lingjiawang511/ali_main_control/ali_main_control/调试备注.txt

外部信号的输入都用switch语言判断，0-1-0，1-0-1，这两个过程代表一个接收状态的完整。比如电机启动的时候先检测一下传感器的信号，
记录当下的状态，如果是1，那么下一个状态必然为0，当再下一个状态为1是代表回到原点，要停止电机。出药检测同理。
按键输入和装药管检测使用定时器扫描检测。

		通讯协议
1、使用扫描头通讯协议，以每个柜组发药单为帧，没帧里面包含N个通道的发药数量，PC上位机一次性发送给主控板，主控板解析后发给发药柜组，发药柜组反馈
状态先保存在主控板，等主控板接收完所有的反馈状态，以帧为单位主动上传给PC上位机，PC发药之后需要等待接收到状态之后才可以进行下一次发药，但是两个
柜组相互独立，PC没接收到1柜组的发药状态是可以对2柜组发药的。
2、通讯方式使用应答方式，上位机发数据给下位机，下位机收到后马上应答收到的数据是否正确。然后执行发药，发药完成后下位机把发药状态发给上位机
3、通讯总共16个字节，帧头尾四个字节，数据10个字节，校验2个字节。
4、通讯采用交换主从机模式，发药前，上位机是主机，下位机是从机！发药后下位机是主机，上位机是从机。
5、PC机发送控制信号，MCU接收到正确的信号，响应一次并转化为主机模式，执行相应动作，如果PC此时因为干扰没有收到正确的响应而继续发控制数据，MCU不作处理，需要上位机自己做判断。
	连续发三次无响应当正确接收处理。MCU执行完相应的动作后。主动发送结果信息给PC机，PC正确响应马上转化为从机模式以接受下一次控制信息，PC机错过响应超过三次当正确响应处理，
	如果PC机一直没有响应，超时后当正确处理，同样转化为从机模式。

////***************************下位机和上位机通讯协议 上位机发送***********************************////

05 06 01 04 01 01 02 A3 07    //柜组1,4行1列发药2盒
05 06 01 04 10 01 02 F3 02    //柜组1,4行16列发药2盒

05 06 02 04 01 01 02 E7 07   //柜组2,4行1列发药2盒
05 06 02 04 10 01 02 B7 02   //柜组2,4行16列发药2盒
05 06 02 04 08 01 02 37 05   //柜组2,4行8列发药2盒

05 06 01 05 01 01 02 A2 FB   //柜组1,5行1列发药2盒
05 06 01 05 10 01 02 F2 FE   //柜组1,5行16列发药2盒

05 06 02 05 01 01 02 E6 FB   //柜组2,5行1列发药2盒
05 06 02 05 10 01 02 B6 FE   //柜组2,5行16列发药2盒
05 06 02 05 08 01 02 36 F9   //柜组2,5行8列发药2盒

05 06 00 00 11 10 00 13 A3	//传送皮带向左持续运动
05 06 00 00 11 20 00 07 A3	//传送皮带向右持续运动
05 06 00 00 11 00 00 1E	63  //传送皮带向右持续运动
05 06 00 00 11 10 0A 93 A4  //传送皮带向左运动10S
05 06 00 00 11 20 08 06 65  //传送皮带向右运动8S

05 03 00 00 0F 00 01 BF F0 //读取外围机构状态
05 03 00 00 1F 00 01 BE 35   //读取温度
05 03 00 00 2F 00 01 BE 3A  //读取湿度
05 03 00 00 63 00 01 7F ED   //读取版本号

04 06 04 01 01 02 59 3E	 //直接控制水平板发药，不经主控板转发
04 06 04 02 01 02 A9 3E
04 03 04 00 63 00 6C 5F  //直接读取水平板版本号，不经主控板转发

04 06 04 02 0B 02 AF 9E
04 06 04 01 11 02 54 FE
04 06 04 01 0B 02 5F 9E

05 06 01 01 01 01 01 E3 CA
05 06 01 02 01 01 01 E3 8E
05 06 01 03 01 01 01 E2 72
05 06 01 04 01 01 01 E3 06
05 06 01 05 01 01 01 E2 FA
05 06 01 06 01 01 01 E2 BE
05 06 01 07 01 01 01 E3 42
05 06 01 08 01 01 01 E0 56
05 06 01 09 01 01 01 E1 AA
05 06 01 0A 01 01 01 E1 EE
05 06 01 0B 01 01 01 E0 12
05 06 01 0C 01 01 01 E1 66
05 06 01 0D 01 01 01 E0 9A
05 06 01 0E 01 01 01 E0 DE
05 06 01 0F 01 01 01 E1 22

05 06 01 01 01 01 01 E3 CA
05 06 01 01 02 01 01 13 CA
05 06 01 01 03 01 01 42 0A
05 06 01 01 04 01 01 F3 CB
05 06 01 01 05 01 01 A2 0B
05 06 01 01 06 01 01 52 0B
05 06 01 01 07 01 01 03 CB
05 06 01 01 08 01 01 33 C8
05 06 01 01 09 01 01 62 08
05 06 01 01 0A 01 01 92 08
05 06 01 01 0B 01 01 C3 C8
05 06 01 01 0C 01 01 72 09
05 06 01 01 0D 01 01 23 C9
05 06 01 01 0E 01 01 D3 C9
05 06 01 01 0F 01 01 82 09
05 06 01 01 10 01 01 B3 CF
