lingjiawang511/ali_main_control/阿里售药柜控制板与PC机通讯协议V15.00.02.DOCX

阿里售药柜控制板与PC机通讯协议V15.00.02 2018-12-20

1、初始版本号：V15.00.00 创建日期：2018-11-28

2、历史版本号：V15.00.01 修改日期：2018-12-11 修改格式

3、最新版本号：V15.00.02 修改日期：2018-12-20 增加双通道发药指令

一、PC机与主控板通讯方式要求：

1、2个柜组，每个柜组18层，16通道均分，主控板与PC机采用RS232与网口两种通讯方式,与水平板采用RS485总线通讯方式。16进制格式，(115200，N,8,1)

2、PC机主动向主控板发送发药命令，主控板将水平板的最终发药情况（发药完成、空轨道、卡药）主动上传给PC机；

3、当振动传感器发出振动信号时，主控板将振动信号主动发送给PC机；

4、PC机查询温湿度信号，主控板将读取温湿度数据并上传给PC机；

5、PC机主动向主控板发送其它外围机构命令，主控板接收并执行命令；PC机查询各机构状态，主控板返回各机构当前状态；

6、接收方收到发送方数据时，需要回复数据。

7、ModBus通讯协议分为ASCII模式和RTU模式，主控板采用RTU模式的通讯协议,CRC16(0x8005)校验，低位在前高位在后。115200bps 8bit 1stop none

8、由于水平板支持同时发药所以上位机必须注意以下事项：

1）、每层最多允许3个模块同时工作；

2）、每个柜组最多允许6个模块同时工作；

3）、整台设备最多允许7个模块同时工作。

违反以上规定会引起由电压不足造成出药异常。

二、CRC校验：

Modbus－RTU 使用 CRC（循环冗余检查 Cyclic Redundancy Check）进行纠错。 CRC 码使用 CRC1－16（X16＋X15＋X2＋1）的生成多项式计算得出。

1．CRC 生产顺序

1） CRC 的初始值设置为 FFFFh。

2） 计算命令的首个字节数据（从站地址）和 CRC 的 XOR， 将其结果设定为 CRC。

3） CRC 右移 1bit。

4） 根据 3）的右移移出位为 0 时，重复 3）；

如果移出位为 1 时，将 A001h 和 CRC 进行异或，其結果设置为 CRC，返回至 3）。

5） 3）和 4）反复进行 8 次右移。

6） 命令的下一个字节也同样从 2）到 5）进行反复处理。

7） 将命令的所有字节的完成上述操作后得到纠错的 CRC。

8） 在命令的最后附加 CRC 时， 请将 CRC 的低位字节设定在前，将高位字节设定在后（低字节序）。

2．命令中 CRC 的配置

命令中发送的 16-bitCRC 为低字节序，先发送低位字节、后发送高位字节。 以下用 CRC 的值为 4321h 为例，先发送21h,后发送43h。

3．CRC 错误判定 PC机设置的 CRC 的值与主控板接收的命令数据計算的 CRC 的值比较后，不一致时，判定 CRC 错 误，废弃接受的数据。然后，准备下一次的接收。（不出现报警状态。）

三、主控板与PC机通讯指令格式： Modbus数据结构（16进制格式）

1、发送写命令：PC机—>主控板 AD + 06 + ID(3字节) + Function(2字节) + CRC16(2字节)

从机地址AD:[0] | 命令字Com：[1] | 机构代码ID:[2] | 机构代码ID:[3] | 机构代码ID:[4] | 机构功能Fun[5] | 机构功能Fun[6] | CRC16[7] | CRC16[8]
05:从机地址 | 06:写命令 | Group 组： 01：1柜组 02：2柜组 | Line 行： 发药通道所在行，取值范围：0~30(10进制) | Column 列： 发药通道所在列，取值范围：0~20(10进制) | 01：单通道发药命令 11：双通道发药命令；（新增） | 指定通道的发药数量：1~20(10进制) | CRC_L | CRC_H
| | 0x000011：传送皮带 | | | 0：停止
| | | | | 10：向左运动 20：向右运动 | 0：持续运动 XX：(1~255)秒，运行到设定时间参数后停止
| | 0x000022:闸门 | | | 00：左闸门 0x0，0左关 0x0，1左开 01：右闸门 0x1，0右关 0x1，1右开 | 闸门自动关时间
| | 0x000033:发药超时错误 | | | 0x0000:固定

返回：主控板—>PC机

从机正确接收并可执行主机指令回复：同PC机发送数据相同

从机发生错误时不能执行主机指令回复：

05 + 86 + ID(3字节) + Reason (2字节) + CRC16(2字节)

Reason：不能执行主机指令原因

0004：从机设备故障，从机执行主机请求的动作时出现不可恢复的错误。

0006：从机设备忙碌，从机正忙于处理一个长时程序命令，请求主机在从机空闲时发送信息。

2、发送读命令：PC机—>主控板 PC机查询各机构状况：只查询外设状态(传送皮带、闸门、温湿度、版本号)

从机地址AD:[0] | 命令字KE：[1] | 机构代码ID:[2][3][4] | 机构功能Fun[5] | 机构功能Fun[6] | CRC16[7] | CRC16[8]
05:从机地址 | 03:读命令 | 0x00000F:外围机构状态代码 | 0x0001：固定格式 | | CRC_L | CRC_H
| | 0x00001F：温湿度状态代码
| | 0x000063:读取版本号代码

从机回复：主控板—> PC机 主控板返回各机构状况 05 + 03 + ID(3字节) + Station(2字节) + CRC16(2字节)

从机地址AD:[0] | 命令字KE：[1] | 机构代码ID:[2][3][4] | 机构功能Fun[5] | 机构功能Fun[6] | CRC16[7] | CRC16[8]
05:从机地址 | 03:读命令 | 0x00000F: 外围机构状态代码 | 低4位： 0：左闸门关闭 1：左闸门打开 2：左闸门打开或者关闭异常报警 3：左闸门发生堵药报警，此时闸门处于打开状态 高4位： 0：传送皮带停止 2：传送皮带左转 3：传送皮带右转 | 低4位： 0：电动滚筒无报警 1：电动滚筒有报警 高4位： 0：右闸门关闭 1：右闸门打开 2：右闸门打开或者关闭异常报警 3：右闸门发生堵药报警，此时闸门处于打开状态 | CRC_L | CRC_H
| | 0x00001F：温度状态代码 | 温度 (最高位是正负符号位) | 温度
| | 0x00002F: 湿度状态代码 | 湿度（湿度只有正数） | 湿度
| | 0x000063:读取版本号代码 | Version(2字节)

3、主控板主动向PC机上传数据： 将发药最终状态、振动传感器有信号、有取药动作时主动上传

AD + Command + ID(3字节) + State + Result + CRC16(2字节)

从机地址AD:[0] | 命令字Com：[1] | 机构代码ID:[2] | 机构代码ID:[3] | 机构代码ID:[4] | 状态 State[5] | 结果 Result[6] | CRC16[7] | CRC16[8]
06:PC机地址 | 06:写命令 | Group 组： 01：1柜组 02：2柜组 | Line 行： 发药通道所在行，取值范围：0~30(10进制) | Column 列： 发药通道所在列，取值范围：0~20(10进制) | 指定通道的已经完成的发药数量。 | 发药机反馈状态： 02时为命令正常完成； 03时为命令完成后通道堵塞； 04时为命令完成，但药品未完全发出 | CRC_L | CRC_H
| | 0x000041：振动传感器 | | | 0x0001：有振动发生
| | 0x000051:取药动作 | | | 0x0001：有取药动作
| | 0x000061:有药通过闸门 | | | 0x0000：左闸门有药通过 0x0001：右闸门有药通过
| | 0x000071:闸门堵药 | | | 0x0000：左闸门堵药 0x0001：右闸门堵药

PC机回复与主控板发送数据相同

4、发药流程：

1）、PC机向主控板发送传送皮带连续运动指令，主控板回复并执行动作

2）、PC机向主控板发送发药指令

3）、PC机向主控板发送闸门打开指令(根据传送皮带运动方向)

4）、主控板向上位机主动发送发药情况及发药数量，闸门开2s(时间可设置)，闸门关闭 （此过程都由主控板自行完成）

5）、PC机查询各机构状态，若闸门关闭就向主控板发送传送皮带停止指令

6）、主控板向PC机主动发送有取药动作情况，出药完成。

注：如果没有上述一系列发药流程，PC机收到取药动作，可屏蔽此信息，即：取药动作无效

韦乐海茨（上海）医药设备科技有限公司 内部文件 保密
