lingjiawang511/ali_main_control/hardware/V15_电路图（20181207）/阿里售药柜主控板外框图.pdf

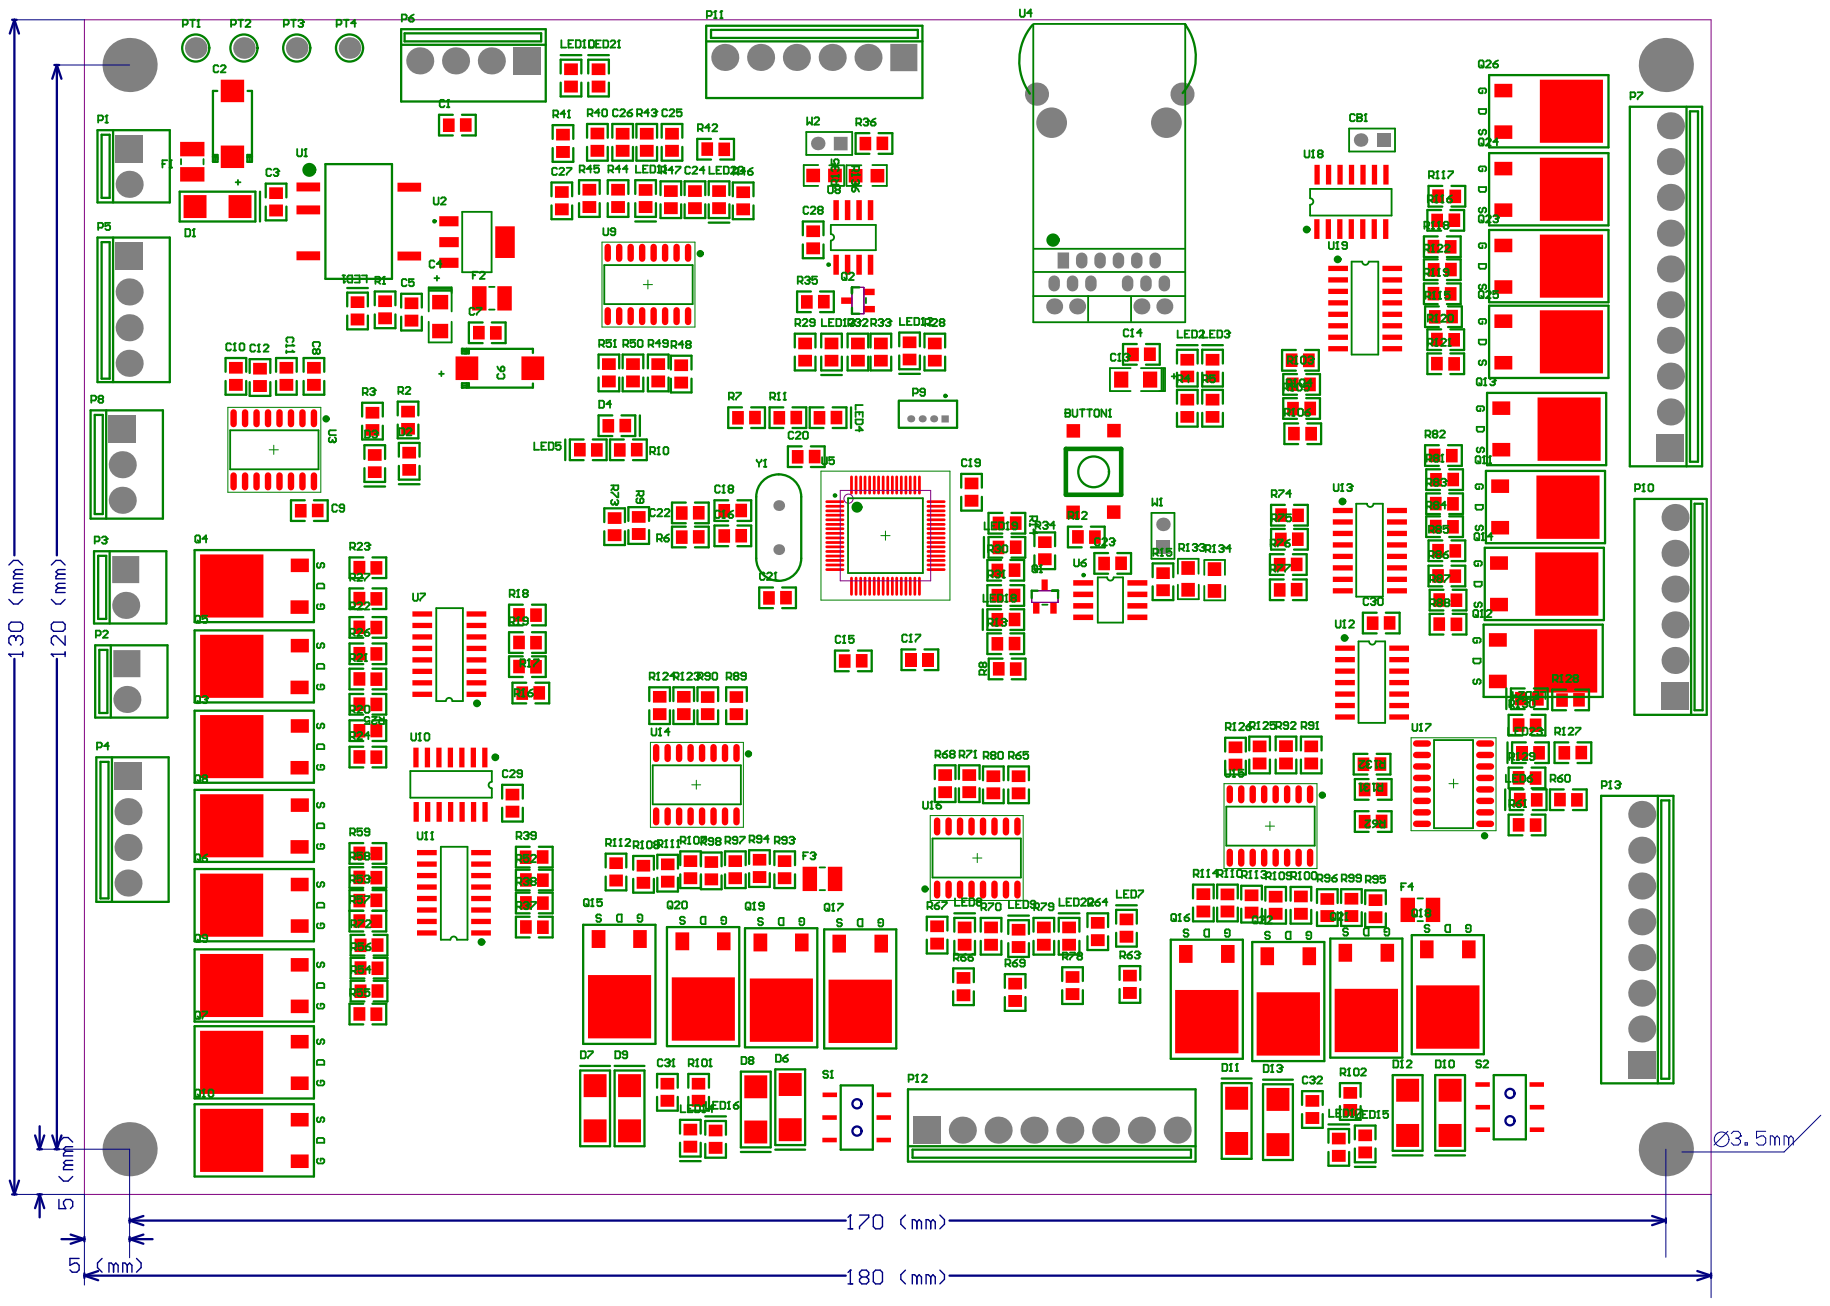
[picture p4: page 1]
