lingjiawang511/ali_main_control/(list of files, drawings)

Other design files:
hardware/Ali_Main_Board/Ali_Main_Board.PrjPCB
hardware/Ali_Main_Board/Ali_Main_Board.SchDoc
hardware/V15_电路图（20181207）/Main Board_V15.PrjPCB
hardware/V15_电路图（20181207）/Main Board_V15.SchDoc
