lingjiawang511/ali_main_control/ali_main_control/include/LGgate.h

#ifndef __LGGATE_H
#define __LGGATE_H

#include "stm32f10x.h"

//baffle_inter 先定义为错误位置，baffle_outer定义为确认位置,BAFFLE_OFF失电是错误位置

#define				A_LEFT_GATE_IO					 GPIO_Pin_3
#define				A_LEFT_GATE_PORT			   GPIOC
#define				A_LEFT_GATE_RCC					 RCC_APB2Periph_GPIOC
#define				B_LEFT_GATE_IO					 GPIO_Pin_0
#define				B_LEFT_GATE_PORT				 GPIOB
#define				B_LEFT_GATE_RCC			  	 RCC_APB2Periph_GPIOB

#define				A_RIGHT_GATE_IO					 GPIO_Pin_1
#define				A_RIGHT_GATE_PORT			   GPIOB
#define				A_RIGHT_GATE_RCC				 RCC_APB2Periph_GPIOB
#define				B_RIGHT_GATE_IO					 GPIO_Pin_12
#define				B_RIGHT_GATE_PORT				 GPIOB
#define				B_RIGHT_GATE_RCC			   RCC_APB2Periph_GPIOB


#define       A_LEFT_GATE_SET   			GPIO_SetBits(A_LEFT_GATE_PORT, A_LEFT_GATE_IO)
#define       A_LEFT_GATE_RESET 	 	 	GPIO_ResetBits(A_LEFT_GATE_PORT,A_LEFT_GATE_IO)
#define       B_LEFT_GATE_SET   			GPIO_SetBits(B_LEFT_GATE_PORT, B_LEFT_GATE_IO)
#define       B_LEFT_GATE_RESET 	 	 	GPIO_ResetBits(B_LEFT_GATE_PORT,B_LEFT_GATE_IO)

#define       A_RIGHT_GATE_SET   			GPIO_SetBits(A_RIGHT_GATE_PORT, A_RIGHT_GATE_IO)
#define       A_RIGHT_GATE_RESET 	 	 	GPIO_ResetBits(A_RIGHT_GATE_PORT,A_RIGHT_GATE_IO)
#define       B_RIGHT_GATE_SET   			GPIO_SetBits(B_RIGHT_GATE_PORT, B_RIGHT_GATE_IO)
#define       B_RIGHT_GATE_RESET 	 	 	GPIO_ResetBits(B_RIGHT_GATE_PORT,B_RIGHT_GATE_IO)

#define      LEFT_GATE_OPEN  				do{A_LEFT_GATE_SET;B_LEFT_GATE_RESET;}while(0);	
#define      LEFT_GATE_CLOSE  			do{B_LEFT_GATE_SET;A_LEFT_GATE_RESET;}while(0);
#define      LEFT_GATE_RELEASE  		do{A_LEFT_GATE_SET;B_LEFT_GATE_SET;}while(0);	

#define      RIGHT_GATE_OPEN  			do{A_RIGHT_GATE_SET;B_RIGHT_GATE_RESET;}while(0);	
#define      RIGHT_GATE_CLOSE  			do{B_RIGHT_GATE_SET;A_RIGHT_GATE_RESET;}while(0);	
#define      RIGHT_GATE_RELEASE  		do{A_RIGHT_GATE_SET;B_RIGHT_GATE_SET;}while(0);


#define				LEFT_OPEN_IO					   	GPIO_Pin_6
#define				LEFT_OPEN_PORT			   		GPIOA
#define				LEFT_OPEN_RCC					 		RCC_APB2Periph_GPIOA
#define				LEFT_CLOSE_IO					 		GPIO_Pin_7
#define				LEFT_CLOSE_PORT				 		GPIOA
#define				LEFT_CLOSE_RCC			  	 	RCC_APB2Periph_GPIOA

#define				RIGHT_OPEN_IO					 		GPIO_Pin_5
#define				RIGHT_OPEN_PORT			  		GPIOC
#define				RIGHT_OPEN_RCC				 		RCC_APB2Periph_GPIOC
#define				RIGHT_CLOSE_IO				 		GPIO_Pin_6
#define				RIGHT_CLOSE_PORT					GPIOC
#define				RIGHT_CLOSE_RCC			   		RCC_APB2Periph_GPIOC


#define READ_LOPEN_SENSOR    		GPIO_ReadInputDataBit(LEFT_OPEN_PORT,LEFT_OPEN_IO)
#define READ_LCLOSE_SENSOR    	GPIO_ReadInputDataBit(LEFT_CLOSE_PORT,LEFT_CLOSE_IO)

#define READ_ROPEN_SENSOR    		GPIO_ReadInputDataBit(RIGHT_OPEN_PORT,RIGHT_OPEN_IO)
#define READ_RCLOSE_SENSOR    	GPIO_ReadInputDataBit(RIGHT_CLOSE_PORT,RIGHT_CLOSE_IO)

#define				LEFT_SHIPMENT_IO					   	GPIO_Pin_4
#define				LEFT_SHIPMENT_PORT			   		GPIOC
#define				LEFT_SHIPMENT_RCC					 		RCC_APB2Periph_GPIOC
#define				RIGHT_SHIPMENT_IO					 		GPIO_Pin_7
#define				RIGHT_SHIPMENT_PORT				 		GPIOC
#define				RIGHT_SHIPMENT_RCC			  	 	RCC_APB2Periph_GPIOC

#define				GETOUT_MEDICINE_IO					 	GPIO_Pin_3
#define				GETOUT_MEDICINE_PORT				 	GPIOB
#define				GETOUT_MEDICINE_RCC			  	 	RCC_APB2Periph_GPIOB

#define READ_LEFT_SHIPMENT_SENSOR    		GPIO_ReadInputDataBit(LEFT_SHIPMENT_PORT,LEFT_SHIPMENT_IO)
#define READ_RIGHT_SHIPMENT_SENSOR    	GPIO_ReadInputDataBit(RIGHT_SHIPMENT_PORT,RIGHT_SHIPMENT_IO)
#define READ_GETOUT_MEDICINE_SENSOR    	GPIO_ReadInputDataBit(GETOUT_MEDICINE_PORT,GETOUT_MEDICINE_IO)



void LRgate_GPIO_Config(void);
void LRgate_Control(void);
void LRgate_Time_Irq(void);
void LRgate_sensor_irq(void );
#endif 
