lingjiawang511/ali_main_control/ali_main_control/USER/baffle.c

#include"HeadType.h"	

#define SCANNER_ERR_TIME  220 //液带进入而扫描不到二维码的时间
#define BAG_ERR_TIME  140		//扫描不到二维码到此液带送走的时间
#define PROCESS_TIME  300
Control_Baffle_Type Baffle_Control;
#define BAFFLE_AUTO_OFF		0
u16 baffle_err_timeout;
//=============================================================================
//函数名称: Printer_GPIO_Config
//功能概要:打印机引脚配置
//参数名称:无
//函数返回:无
//注意    :无
//=============================================================================
 void Baffle_GPIO_Config(void)
{	
	//定义一个GPIO_InitTypeDef 类型的结构体，名字叫GPIO_InitStructure 
	GPIO_InitTypeDef  GPIO_InitStructure;
	//翻板外翻到达输入IO配置
	RCC_APB2PeriphClockCmd(BAFFLE_OUTER_RCC,ENABLE);		
	GPIO_InitStructure.GPIO_Pin = BAFFLE_OUTER_IO;	 
	GPIO_InitStructure.GPIO_Mode = GPIO_Mode_IPU; 		 
	GPIO_InitStructure.GPIO_Speed = GPIO_Speed_10MHz;
	GPIO_Init(BAFFLE_OUTER_PORT, &GPIO_InitStructure);
	//翻板内翻到达输入IO配置
	RCC_APB2PeriphClockCmd(BAFFLE_INTER_RCC,ENABLE);		
	GPIO_InitStructure.GPIO_Pin = BAFFLE_INTER_IO;	 
	GPIO_InitStructure.GPIO_Mode = GPIO_Mode_IPU; 		 
	GPIO_InitStructure.GPIO_Speed = GPIO_Speed_10MHz;
	GPIO_Init(BAFFLE_INTER_PORT, &GPIO_InitStructure);


	//翻板电磁阀输出IO配置
	RCC_APB2PeriphClockCmd(BAFFLE_RCC,ENABLE);		
	GPIO_InitStructure.GPIO_Pin = BAFFLE_IO;	 
	GPIO_InitStructure.GPIO_Mode = GPIO_Mode_Out_PP; 		 
	GPIO_InitStructure.GPIO_Speed = GPIO_Speed_10MHz;
	GPIO_Init(BAFFLE_PORT, &GPIO_InitStructure);
	
	BAFFLE_INTER ;

}
static u8 baffle_state = 0;
void Update_Baffle_State(u8 updatestate)
{
	if(updatestate == 0){
		baffle_state = 1;
		baffle_err_timeout = BAFFLE_ERR_TIMEOUT;
	}else{
		baffle_state = 0;
	}
}
u8 Read_Baffle_State(void)
{
	  return baffle_state;
}
//挡板没事时都是处在错误的地方，扫描传感器有信号输入开始算两个时间，一个时间是有信号时扫描枪扫到二维码的时间，此时间内扫不到二维码
//给上位机上传一个错误的二维码，让上位机给我一个错误标志；另一个时间是过程总时间，既是传感器有信号到液带运行到终点皮带运行的时间，
//这个时间一到，如果上位机没有给我正确信号，我就当错误处理。
void Baffle_Control_Process(void)
{
	static u8 scannerstate=0;//二维码结果，由上位机给，现在模拟
	if(Device_State == 1){
	#if BAFFLE_AUTO_OFF == 0
		if(Baffle_Control.bag_input_flag == 0){
			if(Control.scanner.state == 1){
					Baffle_Control.Scanner_Err_Time = Baffle_Control.PC_send_process_time-80;		//扫描枪传感器检测到有液带信号，一段时间内扫描枪没有扫到二维码，当作为是错误的液带
					Baffle_Control.process_time = Baffle_Control.PC_send_process_time;
				  Baffle_Control.bag_input_flag= 1;
					Baffle_Control.process_flag = 1;
				  Baffle_Control.scanner_result_old = 0;
			}
		}
	#else 
		if(Baffle_Control.bag_input_flag == 0){
				if(Baffle_Control.PC_send_scanner_result >= 1){
					  Baffle_Control.Scanner_Err_Time = 10;
						Baffle_Control.process_time = 20;	//100ms
						Baffle_Control.bag_input_flag= 1;
						Baffle_Control.process_flag = 1;
						Baffle_Control.scanner_result_old = 0;
				}
		}	
	#endif
		if(Baffle_Control.bag_input_flag ==1){   //此状态清零需要在扫描抢接收到二维码的时候,在此扫不到二维码就上传一个错误信息给上位机
				if(Baffle_Control.Scanner_Err_Time ==0){//然后上位机已经给我一个错误信号标志，如果不给，我也知道错误
					scannerstate = Baffle_Control.PC_send_scanner_result;
					Baffle_Control.PC_send_scanner_result = 0;
					Baffle_Control.scanner_result_old = scannerstate;
					if(scannerstate == 1){
						Baffle_Control.bag_ok_flag = 1;
					}else{
						Baffle_Control.bag_ok_flag = 0;
					}
					Update_Baffle_State(Baffle_Control.bag_ok_flag);
					Baffle_Control.PC_send_scanner_result = 0;
					scannerstate = 0;
					Baffle_Control.bag_input_flag = 0;
					Control.scanner.state = 0;
				}
		}

		if(Baffle_Control.process_time == 0){  //每个过程的时间是固定的
			 if(Baffle_Control.bag_ok_flag == 1){  //扫描枪扫到二维码，上位机发来的确认标志
					BAFFLE_OUTER;
				  Baffle_Control.baffle_state = 1;
				  MCU_Host_Send.control.err_message &=0xFD;
				 /***正确翻门后过一段时间自动翻向错误的地方***/
#if BAFFLE_AUTO_OFF == 1
				  Baffle_Control.auto_turn_off_time = Baffle_Control.PC_send_process_time;
#endif
	//				Control.baffle_inter.state = 0;
	//			  Control.baffle_outer.state = 0;
			}else{
					BAFFLE_INTER;	
				  Baffle_Control.baffle_state = 2;
				  MCU_Host_Send.control.err_message &=0xFE;
	//			  Control.baffle_outer.state = 0;
			}
			Baffle_Control.bag_err_flag = 0;
			Baffle_Control.process_time = Baffle_Control.PC_send_process_time;
			Baffle_Control.process_flag= 0;
		}
#if BAFFLE_AUTO_OFF == 1
		if(Baffle_Control.auto_turn_off_time == 0){
				BAFFLE_INTER;
		}
#endif
	}else{
			Baffle_Control.bag_input_flag = 0;
			Control.scanner.state = 0;
		  Baffle_Control.process_time = 0;
			Baffle_Control.bag_err_flag = 0;
			Baffle_Control.process_time = 0;
			Baffle_Control.process_flag= 0;
		  BAFFLE_INTER;	//自由状态都是翻板内翻
	}

	
}

void Baffle_Time_Irq(void)
{
	  static u16 inter_delay_time=0;
	  static u16 outer_delay_time=0;
		if(Baffle_Control.Scanner_Err_Time > 0){
			Baffle_Control.Scanner_Err_Time--;
		}
//    if(Baffle_Control.bag_Err_Time > 0){
//			Baffle_Control.bag_Err_Time--;
//		}
   if(Baffle_Control.process_flag == 1){
		 if(Baffle_Control.process_time >0){
				Baffle_Control.process_time--;
		 }
		}
		if(baffle_err_timeout > 0){
			baffle_err_timeout--;
		}
#if BAFFLE_AUTO_OFF == 1		
		if(Baffle_Control.auto_turn_off_time > 0){
			Baffle_Control.auto_turn_off_time--;
		}
#endif
		if( Baffle_Control.baffle_state == 1){  //外翻不到位故障
				outer_delay_time++;
			  if(outer_delay_time >= 10){
					 if(READ_BAFFLE_OUTER == 0){
							Baffle_Control.baffle_state = 0;
						  outer_delay_time = 0;
					 }else{
							outer_delay_time = outer_delay_time;
					 }
				 }
					if(outer_delay_time >= 160){
							if(READ_BAFFLE_OUTER == 0){
								Baffle_Control.baffle_state = 0;
								outer_delay_time = 0;
							}else{
// 							  Device_State = 3;
								Baffle_Control.baffle_state = 0;
								outer_delay_time = 0;
// 						    MCU_Host_Send.control.err_message |=0x02;
					 }
					 }
		}
		if( Baffle_Control.baffle_state == 2){  //内翻不到位故障
				inter_delay_time++;
			  if(inter_delay_time >= 10){
					 if(READ_BAFFLE_INTER == 0){
							Baffle_Control.baffle_state = 0;
						  inter_delay_time = 0;
					 }else{
							inter_delay_time = inter_delay_time;
					 }
				 }
					 if(inter_delay_time >= 160){
							if(READ_BAFFLE_INTER == 0){
								Baffle_Control.baffle_state = 0;
								inter_delay_time = 0;
							}else{
// 							  Device_State = 3;
								Baffle_Control.baffle_state = 0;
								inter_delay_time = 0;
// 								MCU_Host_Send.control.err_message |=0x01;
					  }
					 }
		}
//		if(Control.baffle_inter.state == 1){   //挡板位置中断状态，现在相当于无用
//				inter_delay_time++;
//			 if(inter_delay_time >= 20){
//					inter_delay_time = 0;
//				  Control.baffle_inter.state = 0;
//				}
//		}
//		if(Control.baffle_outer.state == 1){ //此传感器如果没有，可以用延时状态为代替
//				outer_delay_time++;
//			 if(outer_delay_time >= 300){
//					outer_delay_time = 0;
//				  BAFFLE_INTER ;
//				  Control.baffle_outer.state = 0;
//				}
//		}
}
