lingjiawang511/ali_main_control/(commit log)

2019-01-04 software: add the init project
    [Main Board_V15.PrjPCB, Main Board_V15.SchDoc]
2019-01-05 software:add the usart and LED config
2019-01-05 software: fix the SHT10 program and add the C++ programming mode
    [HeadType.h, TIM.C, communication.c, main.c, sht1x.h]
2019-01-05 fix the SHT10 program and it is OK
    [main.c, sht1x.h]
2019-01-05 software: fix the belt control program
    [HeadType.h, belt.c, belt.h, main.c]
2019-01-07 fix the communication and now the send medicine communication is OK
    [HeadType.h, communication.c]
2019-01-07 software: fix the SHT10 program to the LIB
    [communication.c, main.c, sht1x.h]
2019-01-07 software: add the communication control the belt
2019-01-07 software: this commit is to find the last commit bug
    [communication.c]
2019-01-07 software: fix the SHT10 variable to repair the bug of usart
    [HeadType.h, communication.c, main.c]
2019-01-07 software: fix the communication and now it is OK
    [communication.c, main.c]
2019-01-09 software:fix the communication with ali enginerr
    [Main Board_V15.PrjPCB, Main Board_V15.SchDoc]
2019-01-09 software:fix the Right gate bug,because the GPIO is exit
    [main.c]
2019-01-09 software:fix the communication with the temperature and humidity data
    [communication.c]
2019-01-10 software:fix the communication with the shipment and getout medicine
    [HeadType.h, LGgate.c, LGgate.h, communication.c, communication.h, main.c, sht1x.h]
2019-01-11 software: fix the communication with the usart auto framing
    [HeadType.h, TIM.C, communication.c, main.c, usart.c]
2019-01-12 software:fix the communication with the belt,lrgate,send medicine bug
    [HeadType.h, LGgate.c, belt.c, communication.c]
2019-01-13 software:fix the shipment err filter param and the gate atuo clonse time
    [HeadType.h, LGgate.c, communication.c]
2019-01-15 software: fix the left right gate status according to the communication
    [HeadType.h, LGgate.c]
2019-01-18 hardware:add the new harware SCH and PCB
    [Ali_Main_Board.PrjPCB, Ali_Main_Board.SchDoc]
2019-01-29 fix the belt control with the new hardware
    [HeadType.h, belt.c, belt.h, communication.c, sht1x.h]
2019-01-29 add the vibration sensor program
    [HeadType.h, communication.c, led.h, main.c, vibration.c, vibration.h]
2019-03-21 This commit is release the versions V2.0
    [Ali_Main_Board.SchDoc]
